AsparaGus116/Romulus-I/Specifications/Romulus-I_ISA.pdf

Opcode | Instruction | Registers | Bits
0 (0000) | Register to Register | RA → RY | Op (4) | RA (4) | X (4) | RY (4)
1 (0001) | Immediate to Register | I → RY | Op (4) | X (8) | | RY (4)

Immediate (16)

2 (0010) | Register to Memory | RA → MRB | Op (4) | RA (4) | RB (4) | X (4)
3 (0011) | Memory to Register | MRA → RY | Op (4) | RA (4) | X (4) | RY (4)
4 (0100) | Bitwise OR | RA || RB → RY | Op (4) | RA (4) | RB (4) | RY (4)
5 (0101) | Bitwise NOT | ~RA → RY | Op (4) | RA (4) | X (4) | RY (4)
6 (0110) | Bitwise AND | RA && RB → RY | Op (4) | RA (4) | RB (4) | RY (4)
7 (0111) | Bitwise XOR | RA ^ RB → RY | Op (4) | RA (4) | RB (4) | RY (4)
8 (1000) | Add | RA + RB → RY | Op (4) | RA (4) | RB (4) | RY (4)
9 (1001) | Subtract | RA - RB → RY | Op (4) | RA (4) | RB (4) | RY (4)
A (1010) | Logical NOT | !RA → RY | Op (4) | RA (4) | X (4) | RY (4)
B (1011) | Logical Shift Right | RA >> 1 → RY | Op (4) | RA (4) | X (4) | RY (4)
C (1100) | Push* (Details below) | (RA or PC+2) → Top stack | Op (4) | RA (4) | Op2 (1) | X (7)
D (1101) | Pop** (Details below) | Top stack → (RY or PC) | Op (4) | X (4) | Op2 (1) | X (3) | RY (4)
E (1110) | Unconditional Jump | RA → PC | Op (4) | RA (4) | X (8)
F (1111) | Conditional Jump*** (Details below) | If (RB ?? 0): RA → PC | Op (4) | RA (4) | RB (4) | | Flags (4)

*Push:
Op2 | Behavior
0 | RA → Top stack
1 | PC+2 → Top stack
A push instruction with Op2 = 1 is essentially the first part of a function call: We store PC+2 so that PC+1 can be the jump instruction and PC+2 will be the instruction memory return address.

**Pop:
Op2 | Behavior
0 | Top stack → RY
1 | Top stack → PC

***Conditional Jump:
Flags | Comparison
0000 | N/A (Instruction functions as a NOP)
0001 | RB == 0
001X | RB != 0
01XX | RB < 0
1XXX | RB > 0
