AsparaGus116/Romulus-I/Specifications/Control_Signals_FSM.png

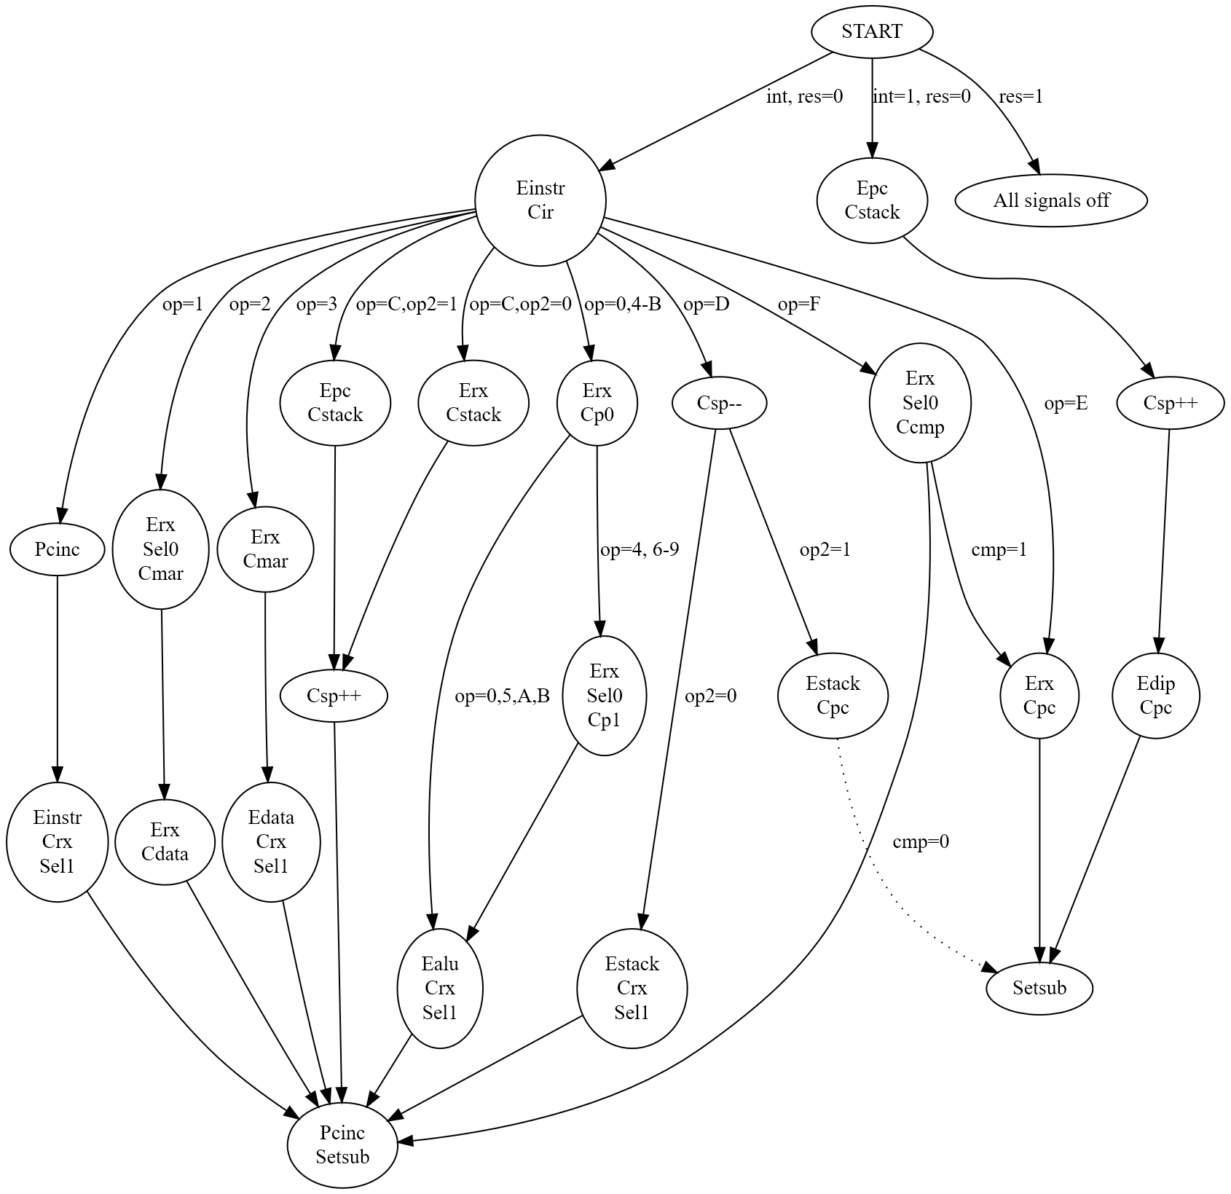
Specifications/Control_Signals_FSM.png
