AsparaGus116/Romulus-I/Specifications/Schematics/Romulus I - Finite State Machine and Reset Board Schematic.pdf

## ROTARY SWITCH POSITIONS:

## 1: INC INSTR

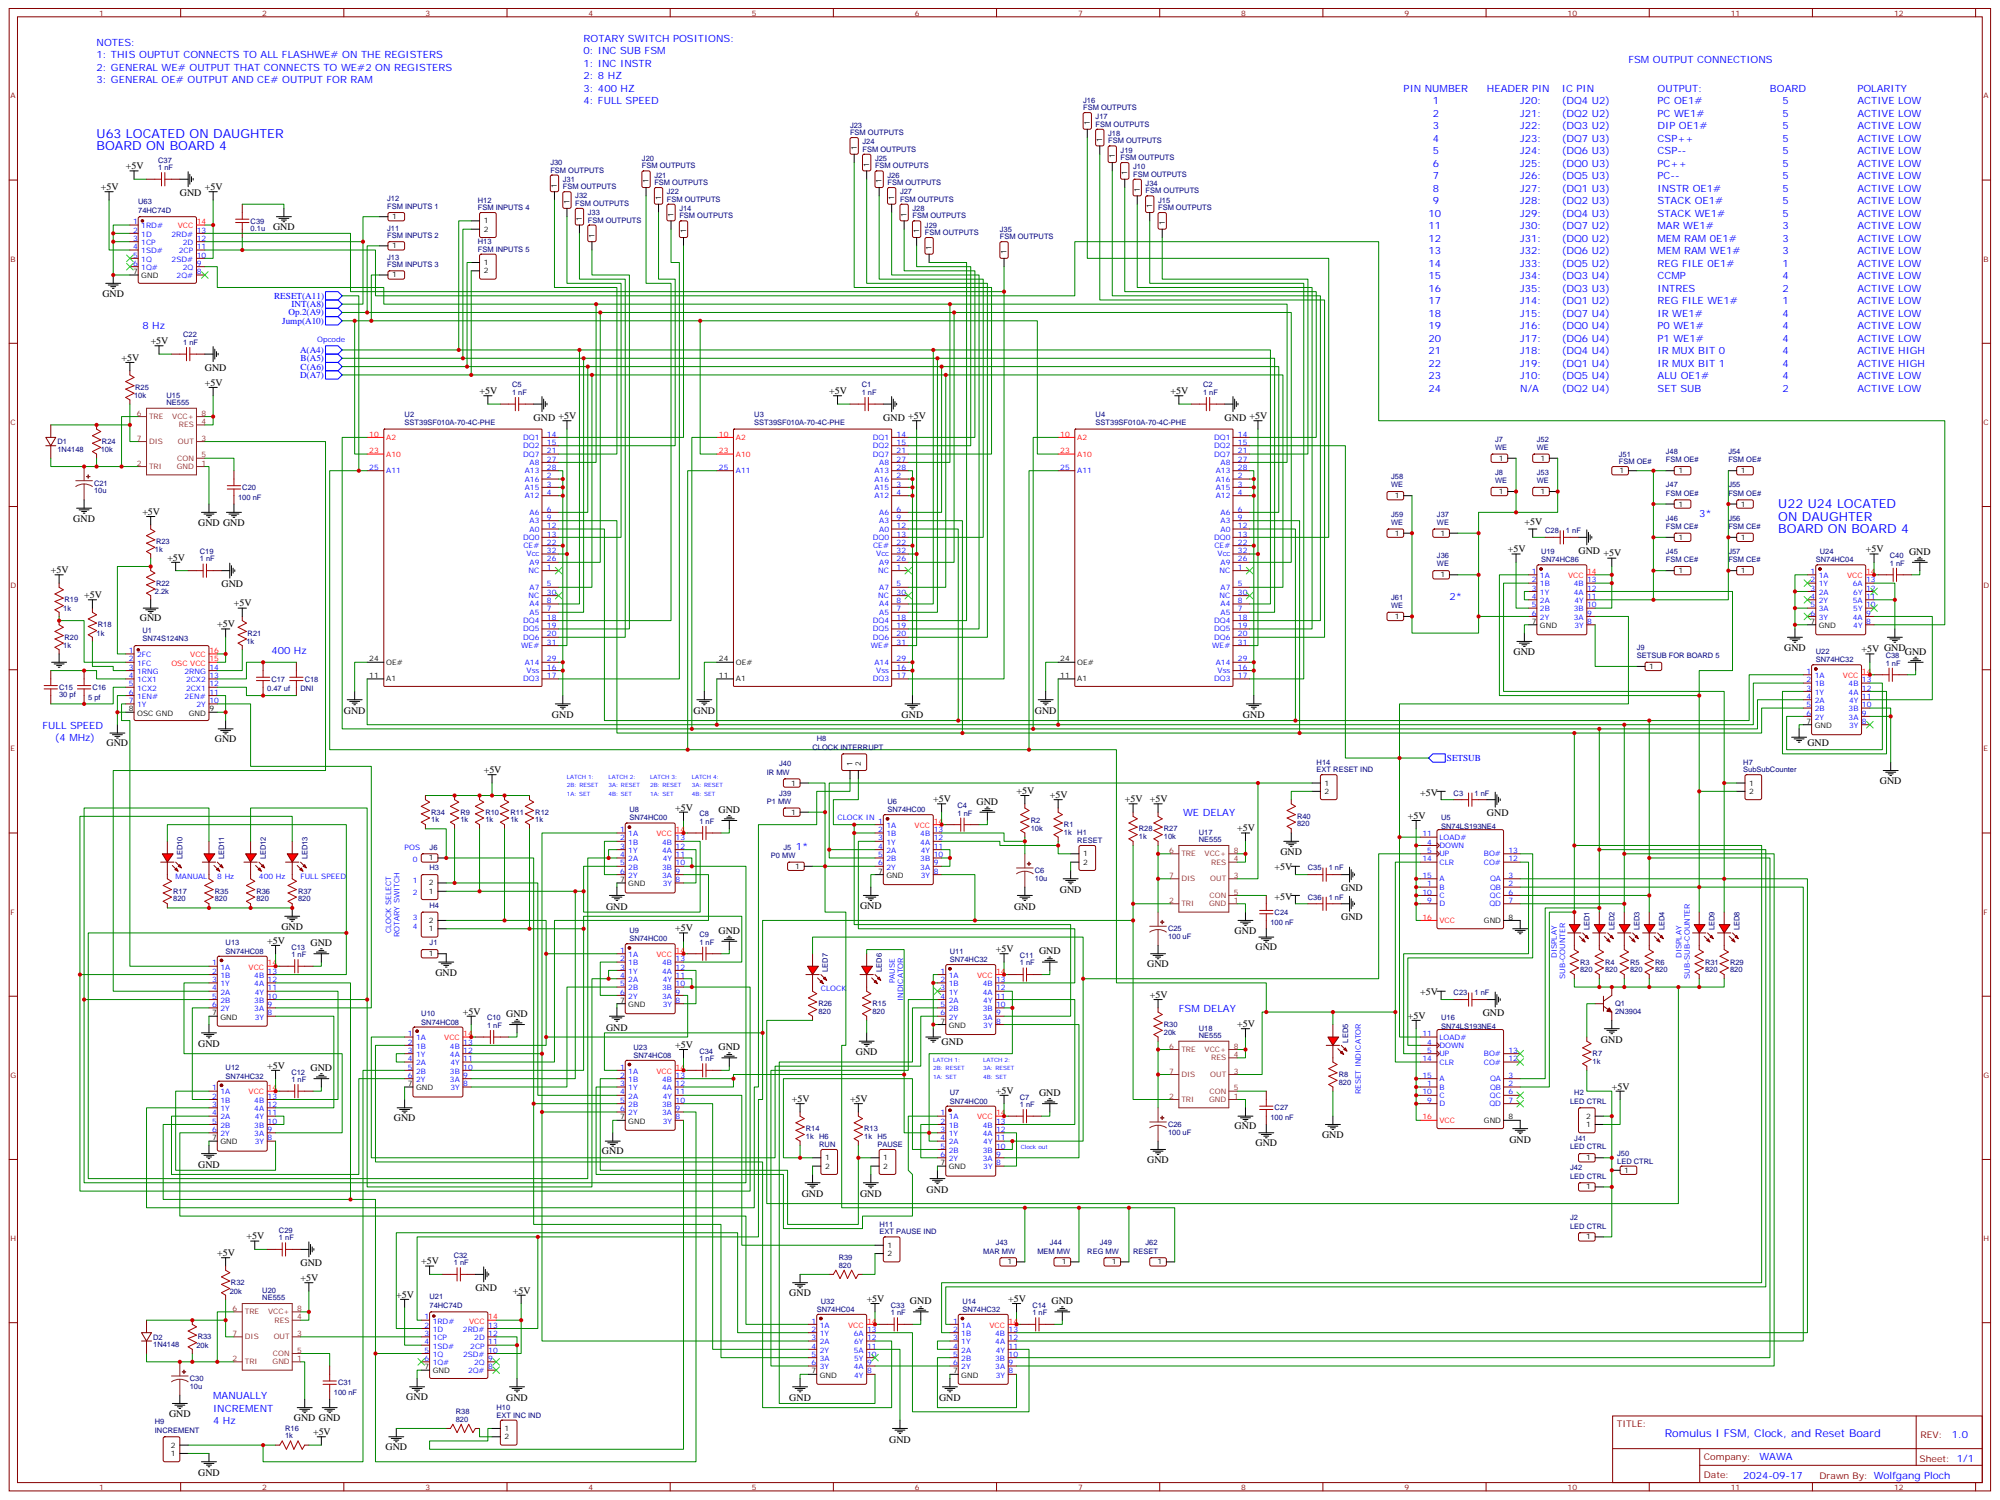
[picture p2: page 1]

NOTES:
1: THIS OUPTUT CONNECTS TO ALL FLASHWE# ON THE REGISTERS
2: GENERAL WE# OUTPUT THAT CONNECTS TO WE#2 ON REGISTERS
3: GENERAL OE# OUTPUT AND CE# OUTPUT FOR RAM

Drawn By: Wolfgang Ploch
