AsparaGus116/Romulus-I/Specifications/Schematics/Romulus I - Memory and Mapped IO Board Schematic.pdf

## PIN NOTES 1* SELECT MEMORY (ACTIVE LOW)

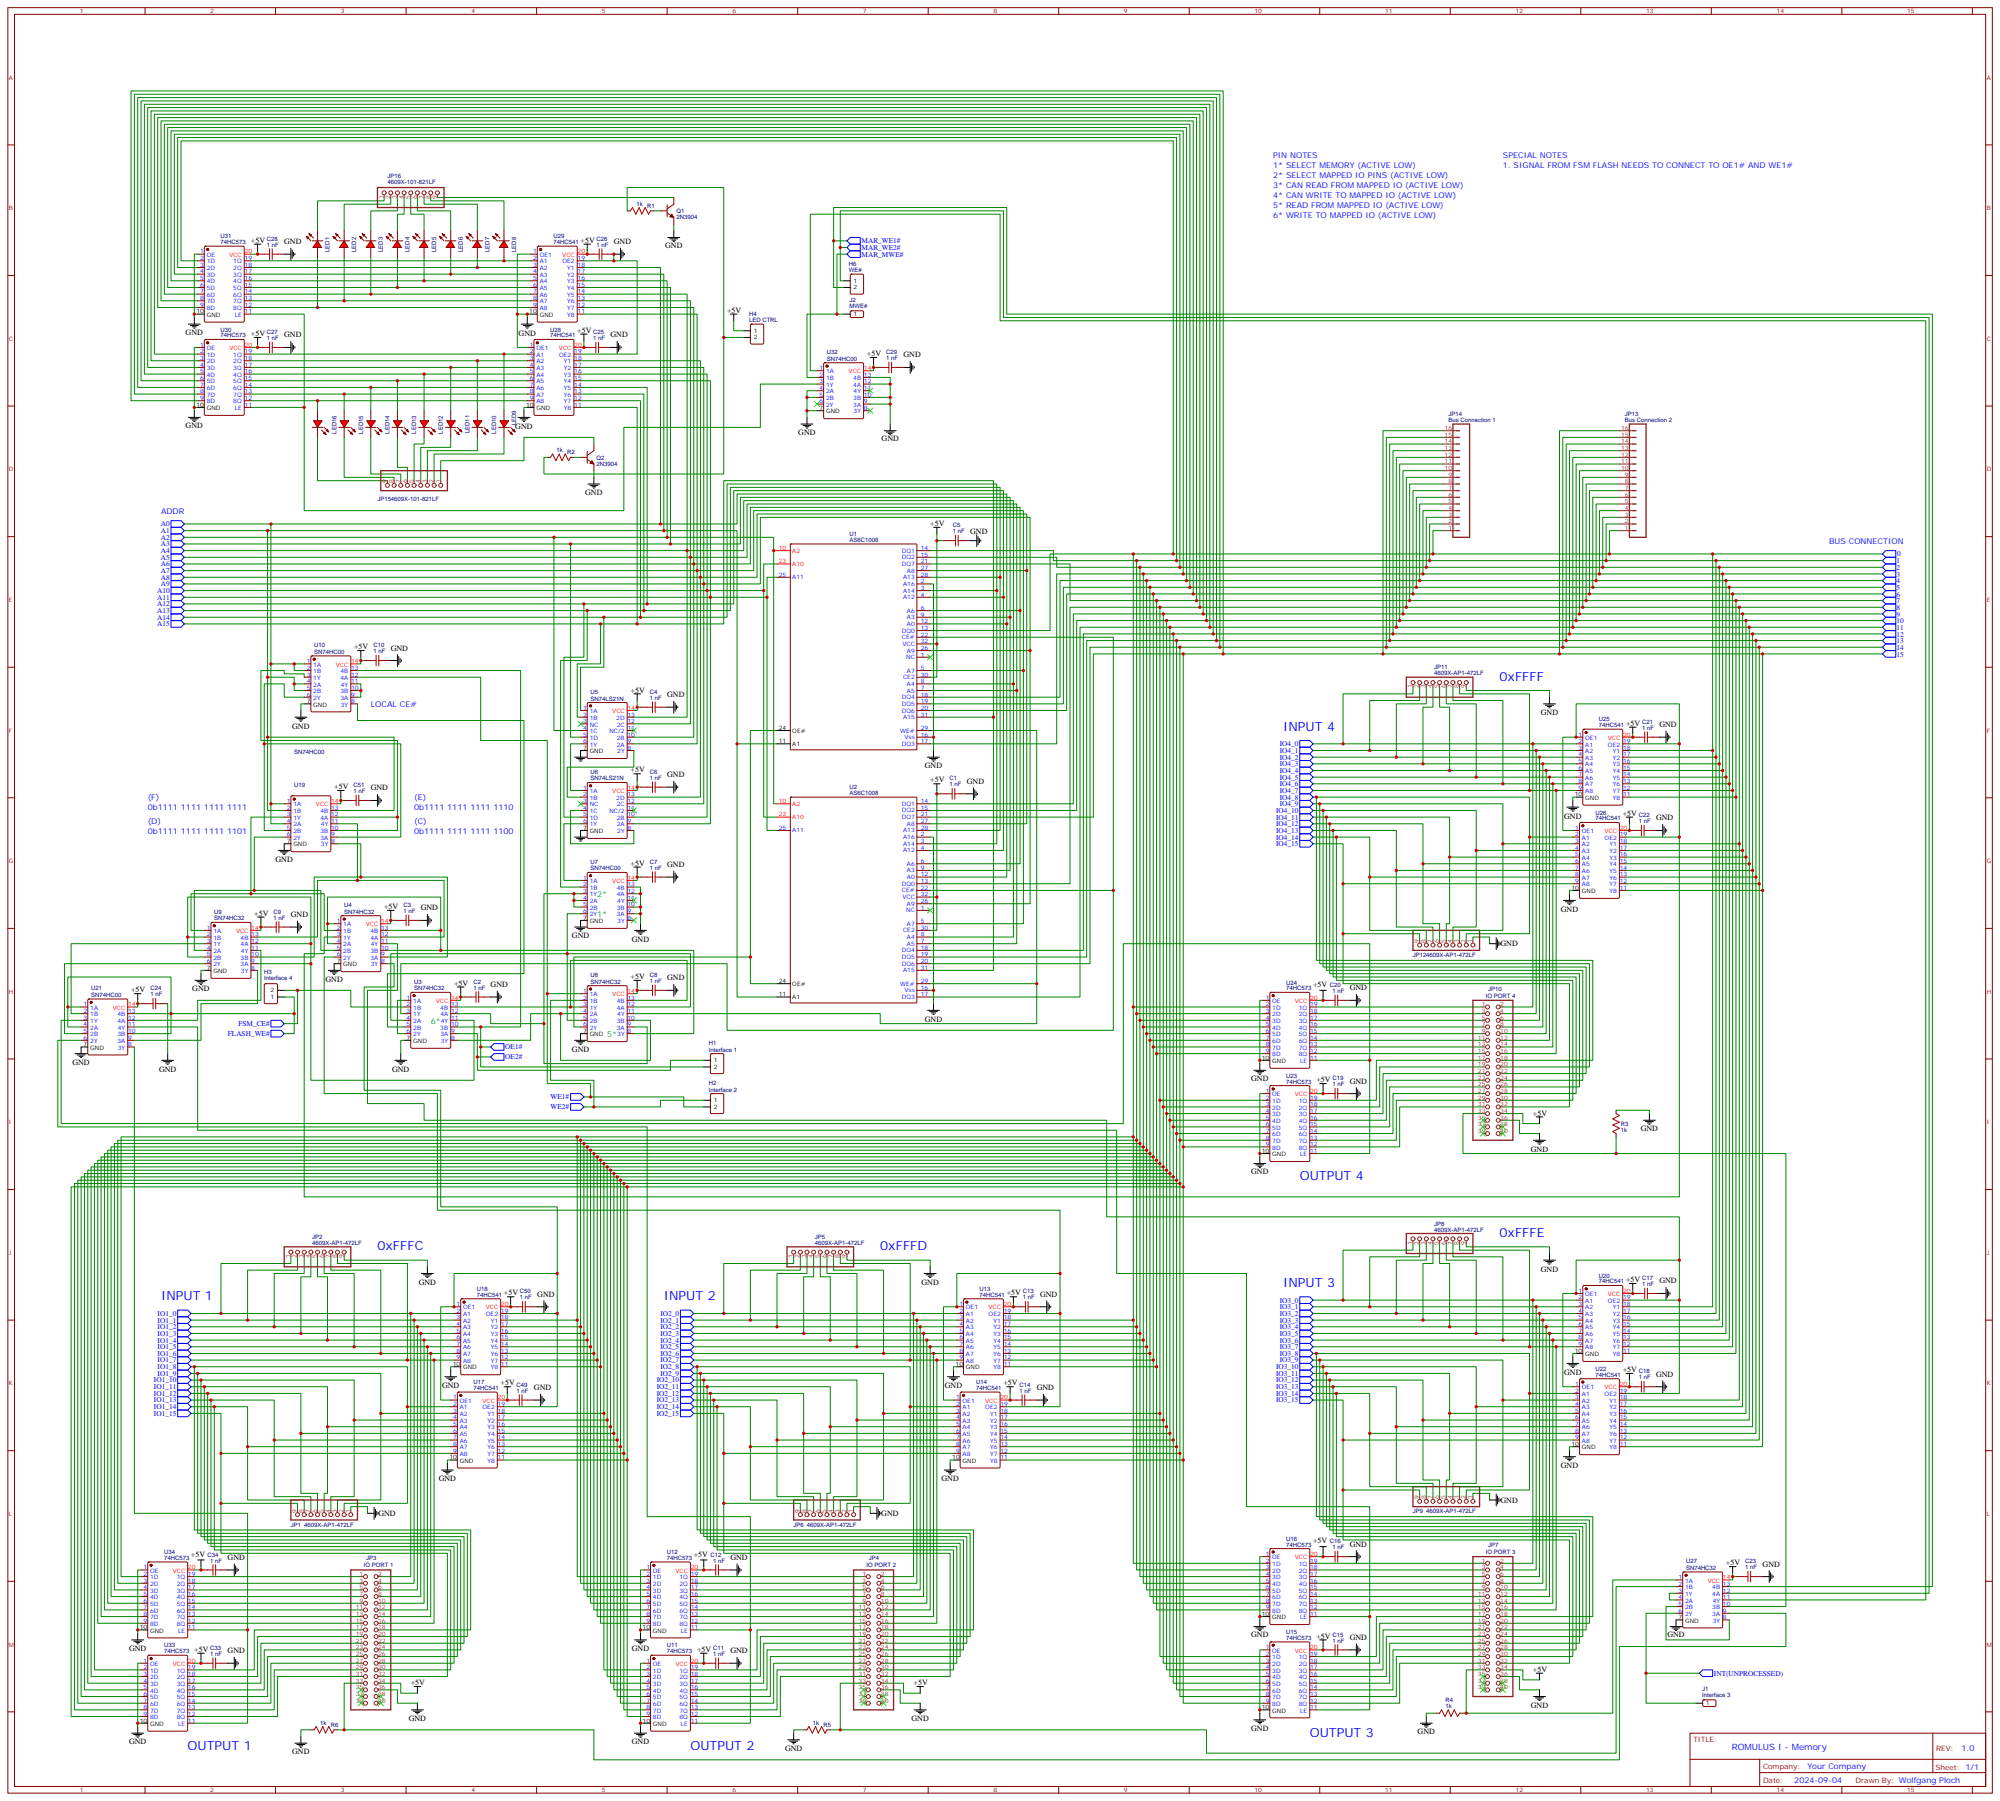
[picture p3: page 1]

SPECIAL NOTES
1. SIGNAL FROM FSM FLASH NEEDS TO CONNECT TO OE1# AND WE1#

2* SELECT MAPPED IO PINS (ACTIVE LOW)
3* CAN READ FROM MAPPED IO (ACTIVE LOW)
4* CAN WRITE TO MAPPED IO (ACTIVE LOW)
5* READ FROM MAPPED IO (ACTIVE LOW)
6* WRITE TO MAPPED IO (ACTIVE LOW)

10

9 12
10 11

Drawn By: Wolfgang Ploch
