AsparaGus116/Romulus-I/Specifications/Schematics/Romulus I - Register File Board Schematic.pdf

## U69 LOCATED ON DAUGHTER BOARD

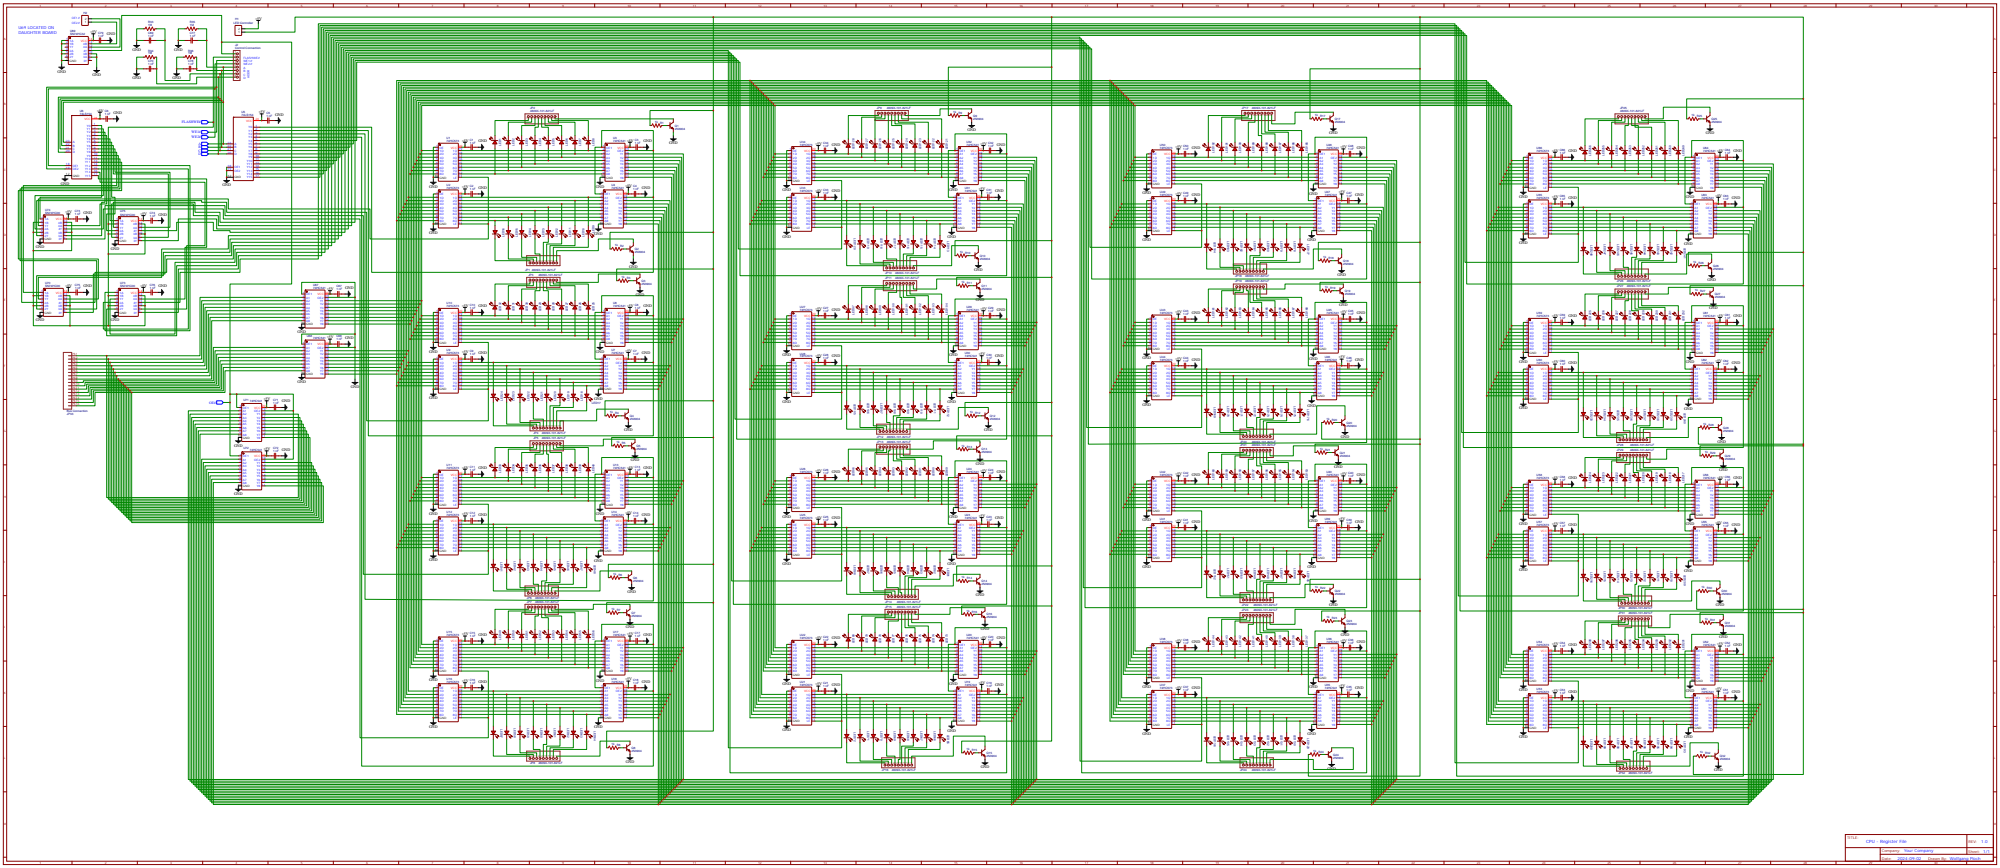
[picture p4: page 1]

Drawn By: Wolfgang Ploch
