AsparaGus116/Romulus-I/Specifications/Schematics/Romulus I - Stack and Instruction RAM Board Schematic.pdf

## INTRUCTION ADDR

## STACK RAM

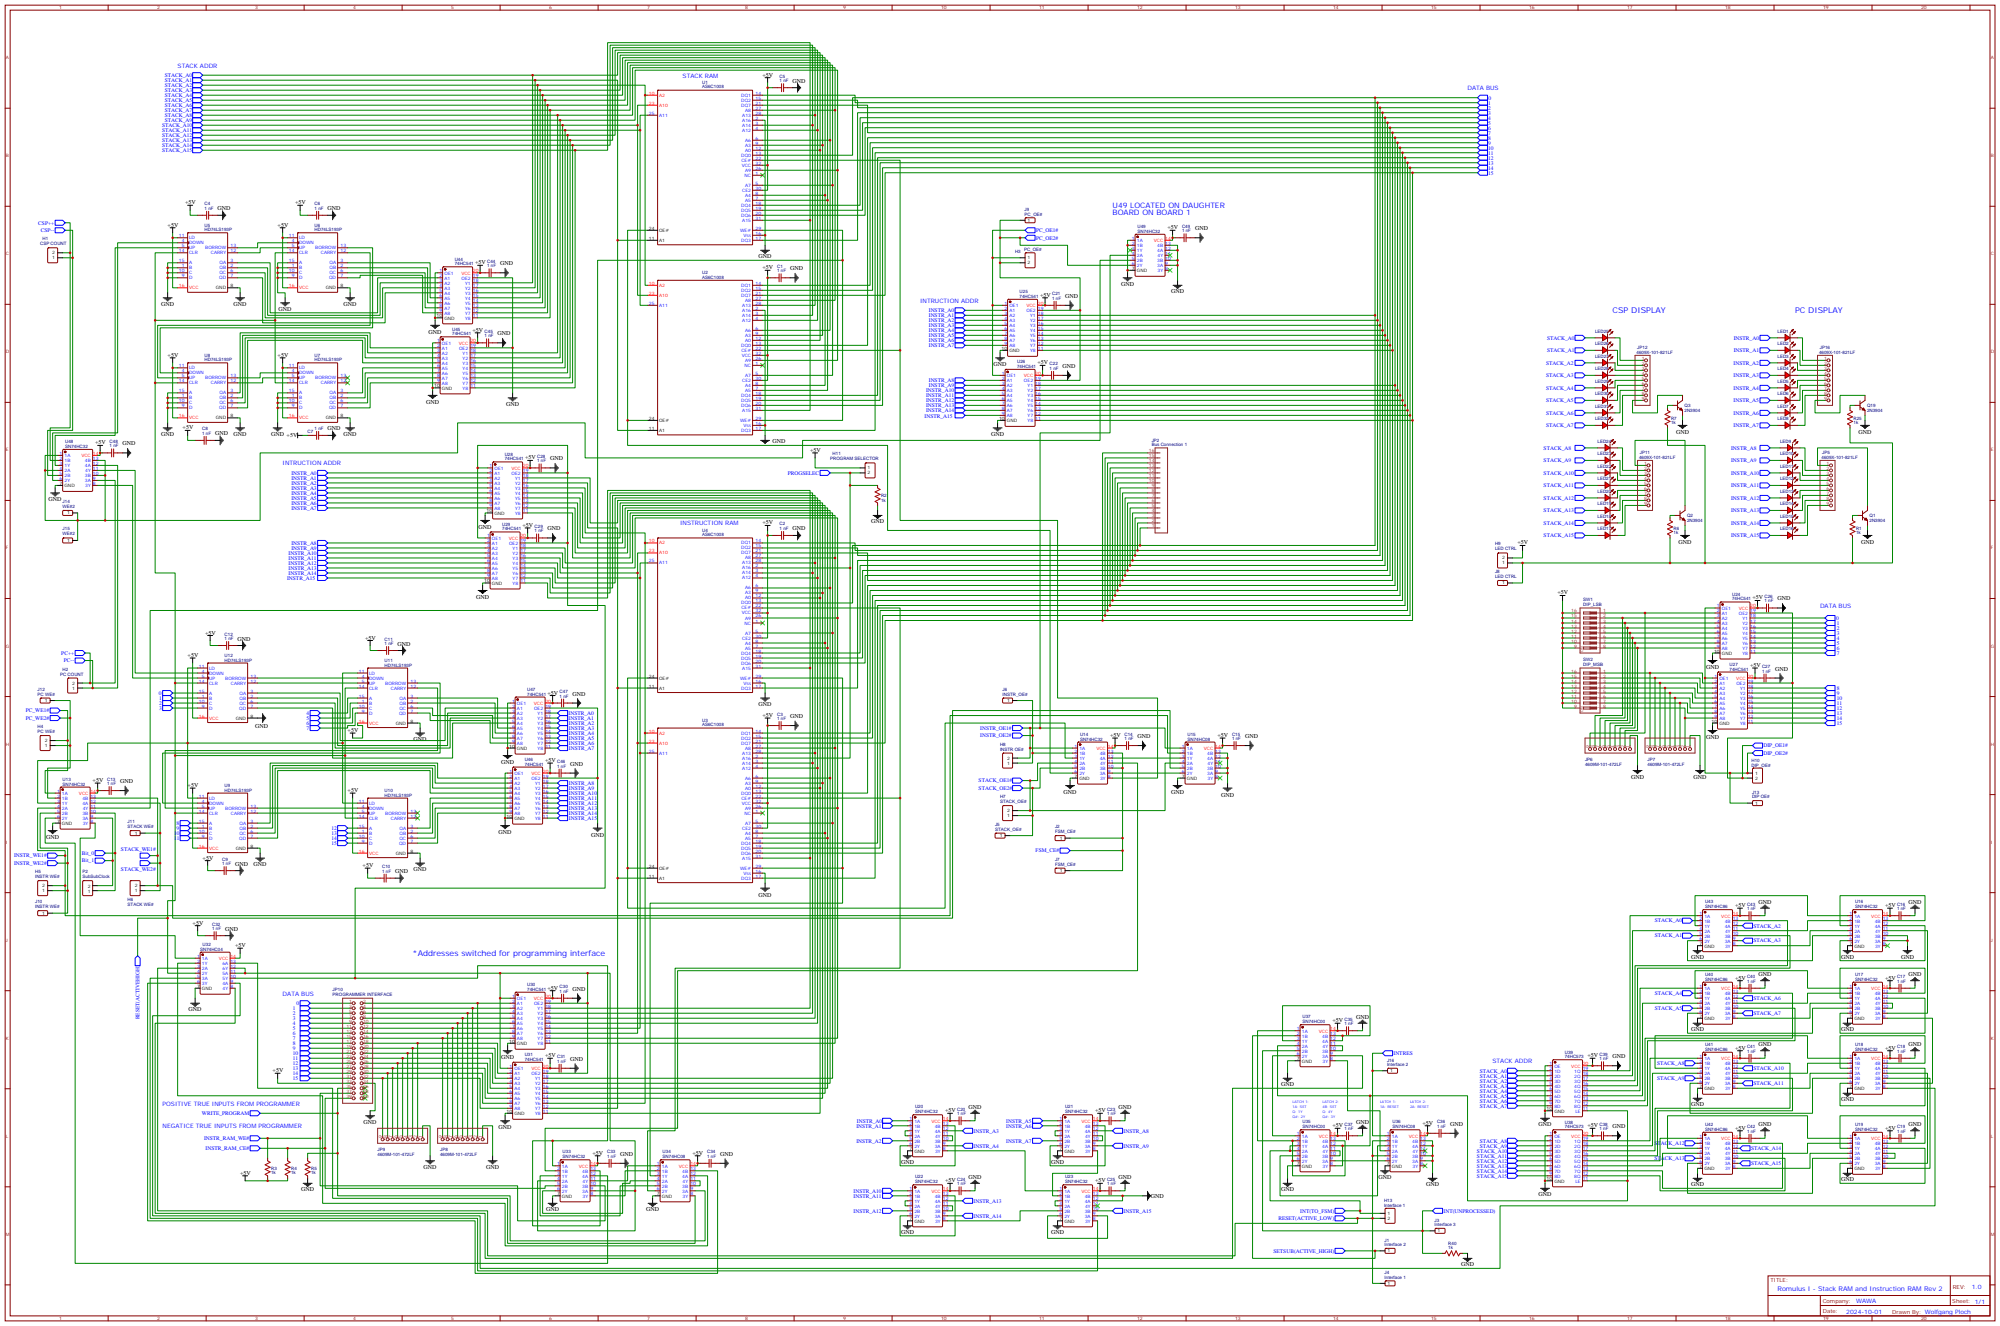
[picture p5: page 1]

UP 5 9 12
CLR 14 10 11

*Addresses switched for programming interface

POSITIVE TRUE INPUTS FROM PROGRAMMER

NEGATICE TRUE INPUTS FROM PROGRAMMER

Drawn By: Wolfgang Ploch
