AsparaGus116/Romulus-I/Specifications/Schematics/Romulus I - Power Supply Schematic.pdf

## GND GND

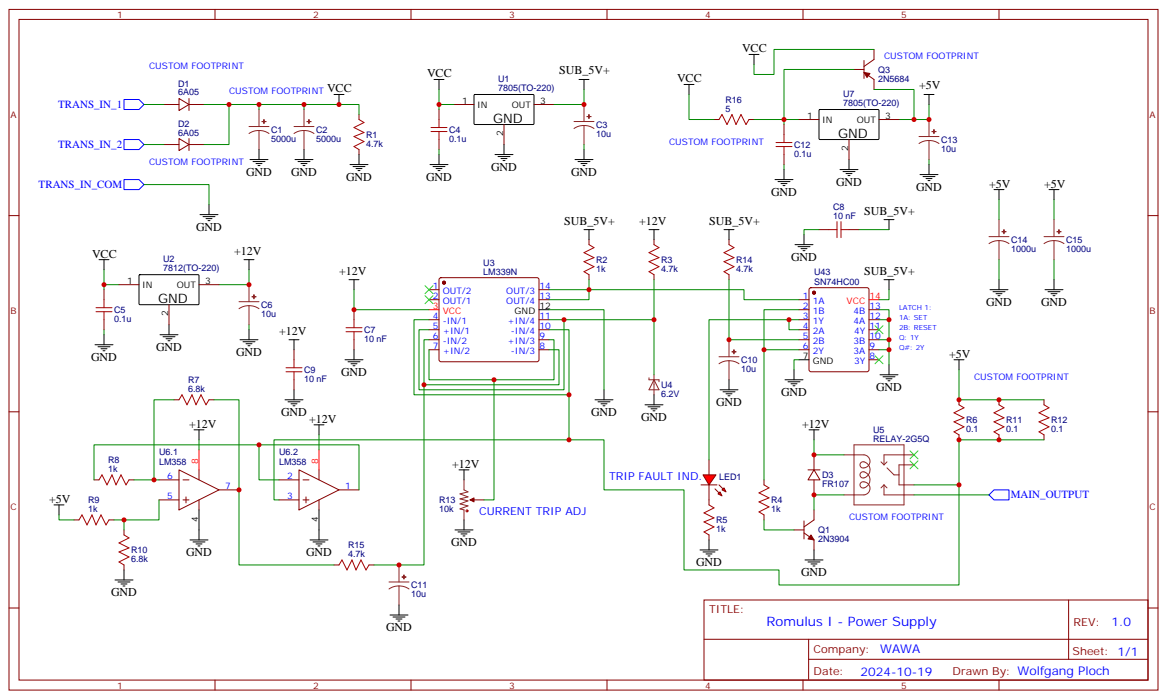
[picture p6: page 1]

Drawn By: Wolfgang Ploch
