AsparaGus116/Romulus-I/Specifications/PCB_Layouts/Romulus I - FSM Board PCB.pdf

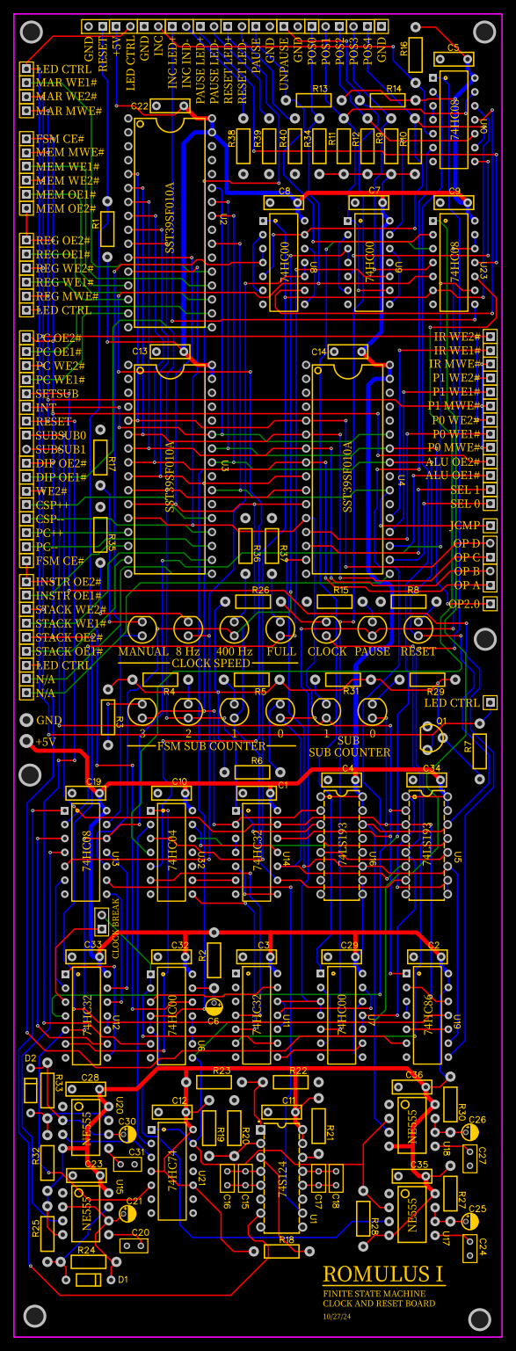
[picture p7: page 1]
