AsparaGus116/Romulus-I/Specifications/PCB_Layouts/Romulus I - Power Supply PCB.pdf

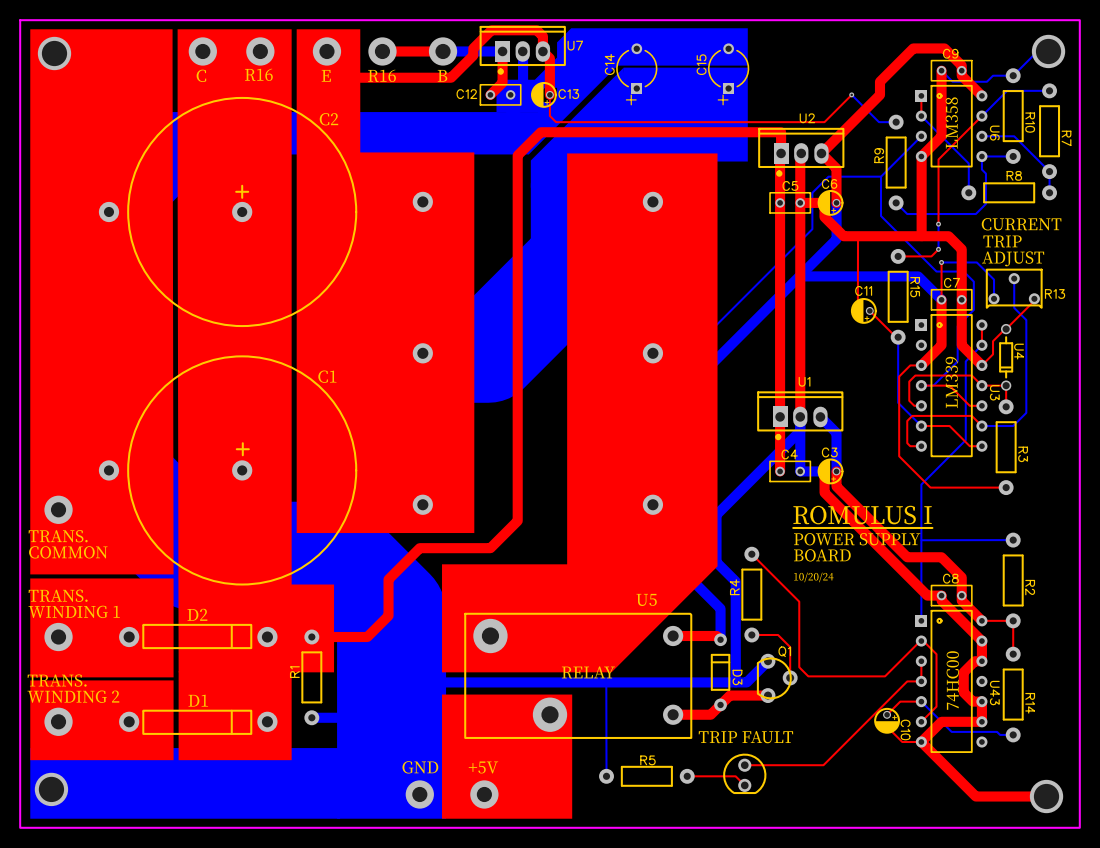
[picture p8: page 1]
