AsparaGus116/Romulus-I/Specifications/PCB_Layouts/Romulus I - Register File PCB.pdf

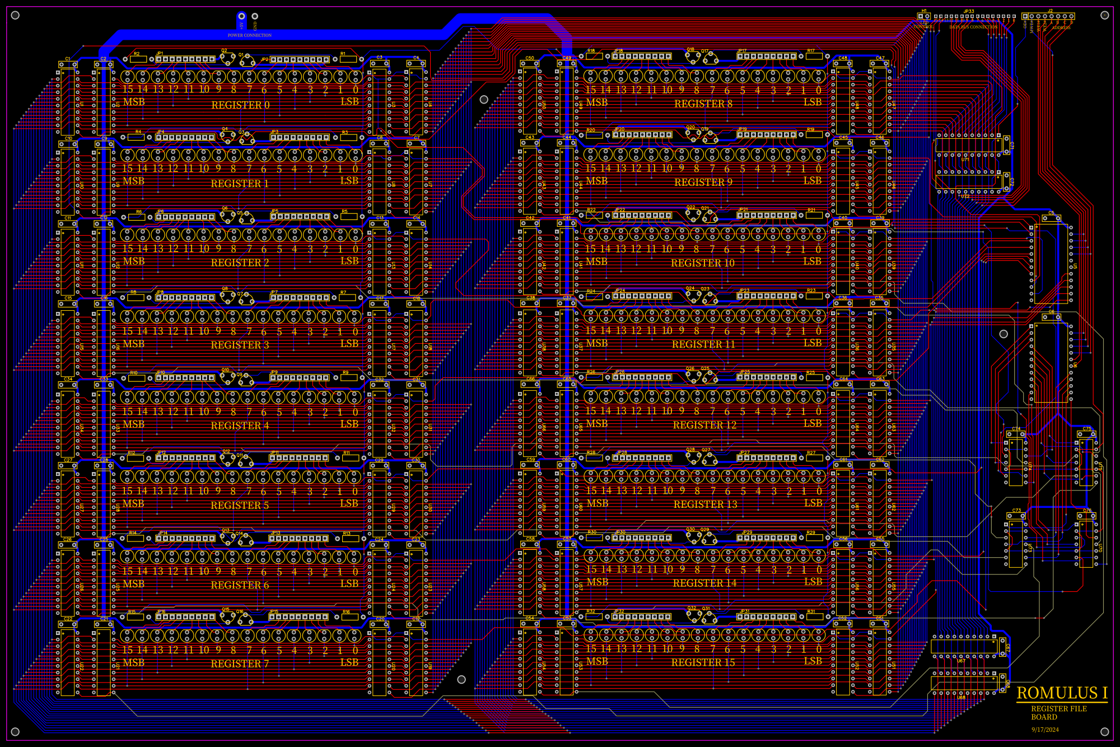
[picture p9: page 1]
