AsparaGus116/Romulus-I/Specifications/PCB_Layouts/Romulus I - Memory and Mapped IO PCB.pdf

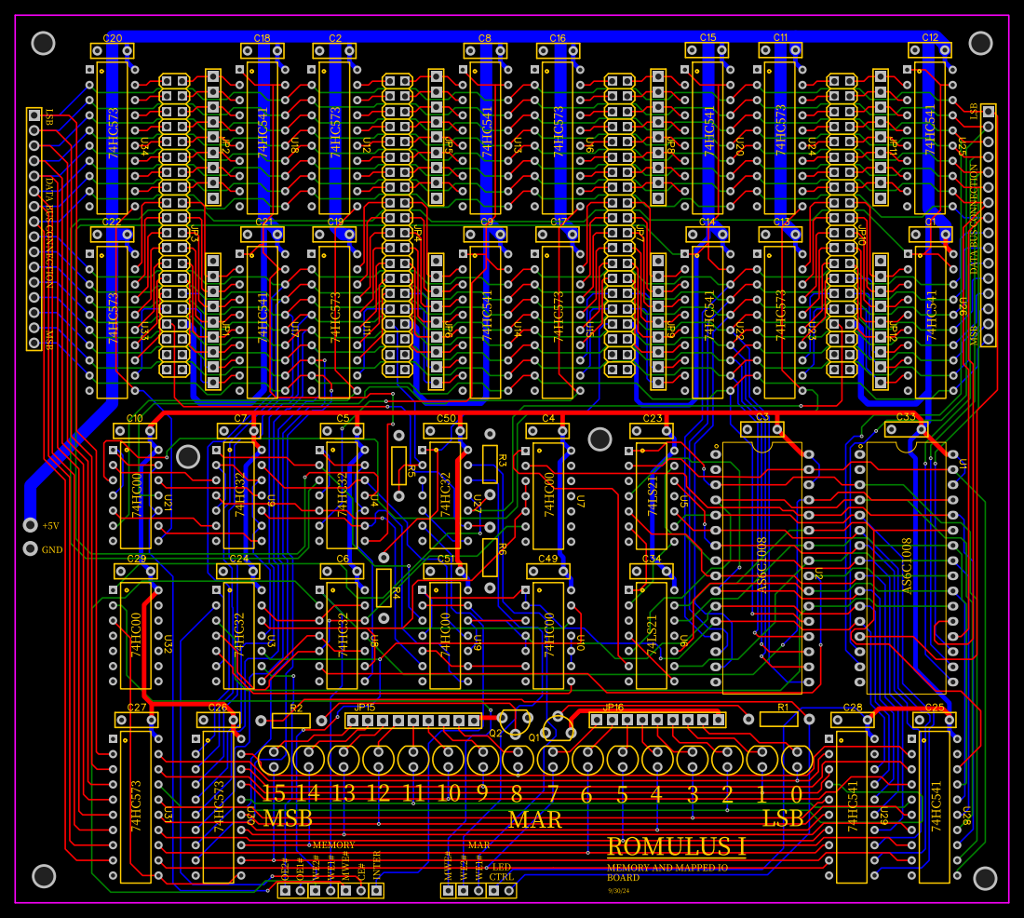
[picture p10: page 1]
