AsparaGus116/Romulus-I/Specifications/PCB_Layouts/Romulus I - Stack and Instruction RAM PCB.pdf

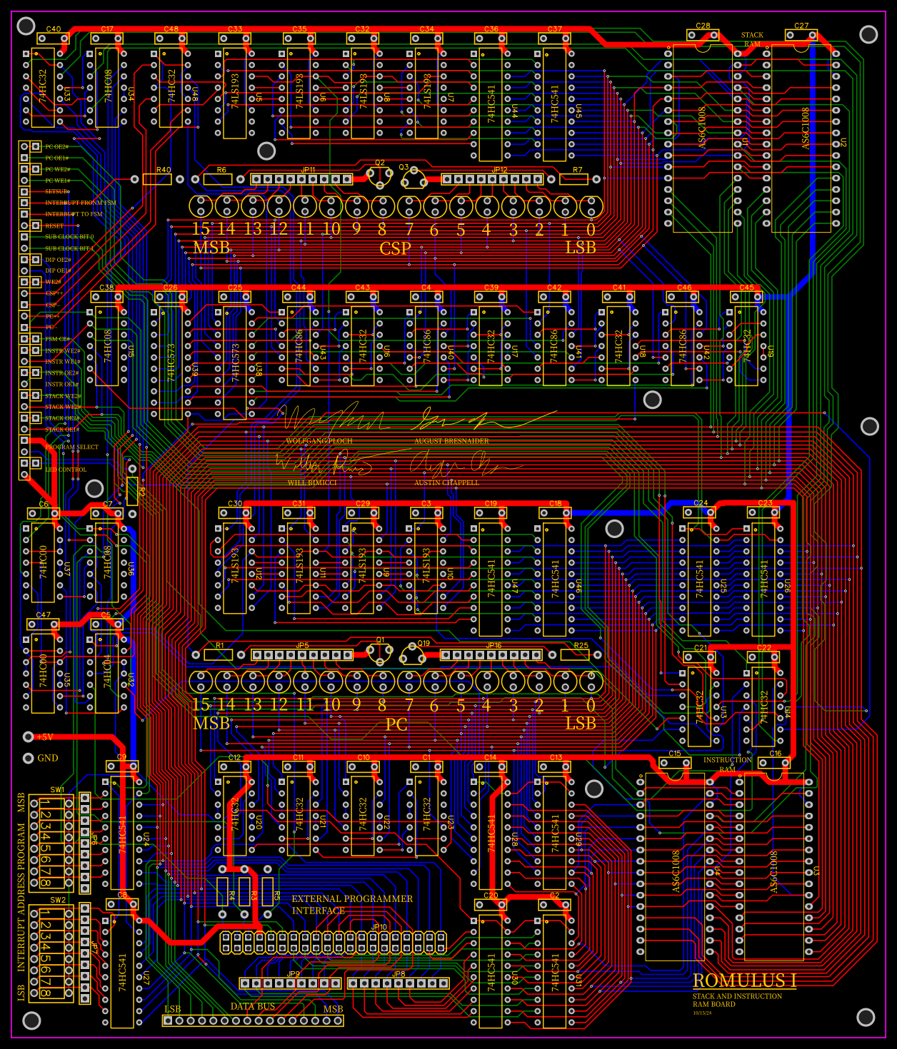
[picture p11: page 1]
