AsparaGus116/Romulus-I/(commit log)

2024-09-03 Added Register File Schematic
2024-09-10 Updated GANTT chart format
    [GANTT.xlsx]
2024-09-11 Fixed unary formatting edge case
2024-09-26 Added Assembler Code
2024-09-30 Added working assembler
2024-10-29 Added most schematics / PCBs
2024-10-29 Wiped Assembler Files
2024-10-29 Wiped assembler intermediate files
2024-10-29 Hopefully last assembler/compiler cleanup
2024-10-29 Refactored Assembler code
2024-10-29 Adjusted assembler build to be system-agnostic and fit with refactoring
2024-10-30 Updated assembler / compiler formatting
2024-10-30 Fixed Assembler bug with uppercase hex letters
    [Listener.cpp]
2024-11-06 Adjusted assembler and simulator to better handle lda and str instructions
2024-11-06 Got arduino flasher to work and updated hex files
2024-11-06 Fixed some minor flashing bugs
    [arduinoFlasher.ino]
2024-11-08 Updated flash arduino code (UI updates)
2024-11-13 Updated FSM to add signal for resetting interrupt pin
2024-11-18 Added tester files for LED Matrix
2024-11-29 Added framework for Hawk Compiler
2024-11-29 Fixed flasher ino code
    [arduinoFlasher.ino]
2024-11-29 Fixed flasher code (again)
    [LEDMatrixTester.ino, teletypeFlasher.ino]
2024-11-29 Added NOPs and char immediates to assembly language
2024-12-01 Added framework for assignment statements
2025-09-18 Updated final schematics / PCBs
